JQIamo/analog_adder_10MHz/readme.MD

# Adding Buffer with 10MHz Bandwidth
The project is designed in [Kicad](https://www.kicad.org/) (version6)

NOTE: The +10V offset is now introduced by an LM337. For greater temperature stability other solutions might be considered.
