JQIamo/analog_adder_10MHz/(commit log)

2022-11-16 Almost completed
    TO DO: insert proper filtering capacitors.
    [analog_adder_10MHz.kicad_pcb, analog_adder_10MHz.kicad_sch]
2022-11-16 added resistor to ensure factor 0.25 in voltage divider.
    [analog_adder_10MHz.kicad_pcb, analog_adder_10MHz.kicad_sch]
2022-11-23 legends and minimal set of capacitors added
    [analog_adder_10MHz.kicad_pcb, analog_adder_10MHz.kicad_sch]
2022-11-23 corrections in silkscreen and full DRC run
    [analog_adder_10MHz.kicad_pcb]
2022-11-30 Footprint for jumpers modified: drill diameter set to 0.9mm
    [analog_adder_10MHz.kicad_pcb, analog_adder_10MHz.kicad_sch]
